MaviKulubeliAdam/Automatic-MLA-Tuner/pcb/MLA-Tuner.kicad_sch

## KiCad design pcb/MLA-Tuner.kicad_sch (2025-12-02)

Schematic: MLA-Tuner.kicad_sch

Parts:
ATT1: 20dB_Attenuator; Attenuator_20dB
BR1: SWR_Bridge_T50-2; SWR_Bridge
C1, C3, C4, C5: 100nF; C_0805_2012Metric
C2: 100uF; CP_Radial_D8.0mm_P3.50mm
J1: 5V_DC_Jack; BarrelJack_Horizontal
J2: 12V_DC_Jack; BarrelJack_Horizontal
J3: SMA_ANT_OUT; SMA_Amphenol_132289_EdgeMount
J4: MOTOR_CONN; PinHeader_1x04_P2.54mm_Vertical
J5: ENCODER_CONN; PinHeader_1x05_P2.54mm_Vertical
K1: 5V_Relay_Module; Relay_Module_1CH
M1: NEMA17_Stepper; NEMA17
SW1: Rotary_Encoder; RotaryEncoder_Alps_EC11E-Switch_Vertical_H20mm
SW2: BTN_FORWARD; SW_PUSH_6mm
SW3: BTN_REVERSE; SW_PUSH_6mm
U1: Arduino_Mega2560
U2: AD9833_Module
U3: RF_AMP_1MHz-3GHz; RF_Amplifier_Module
U4: TB6600_Driver
U5: AD8307_FWD; AD8307_Module
U6: AD8307_REF; AD8307_Module

Notes on the sheet:
MANYETIK LOOP AUTO-TUNER PCB v4.0 ================================ Bu PCB tasarımı aşağıdaki modülleri içerir: 1. Arduino Mega 2560 - Ana kontrolör 2. AD9833 DDS - Sinyal üretici (0-12.5 MHz) 3. RF Amplifier - 1MHz-3GHz (+20dB) 4. 5V Röle Modülü - RF Amp güç kontrolü 5. TB6600 - Step motor sürücü 6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
