MaviKulubeliAdam/Automatic-MLA-Tuner/(commit log)

2025-12-02 Add PCB design files for Magnetic Loop Auto-Tuner
    [MLA-Tuner.kicad_pcb, MLA-Tuner.kicad_sch]
2025-12-02 Address code review feedback: fix power pin, documentation links, and clarifications
    [MLA-Tuner.kicad_pcb, MLA-Tuner.kicad_sch]
2025-12-02 Update auto-mla-tuner to support AD9851 DDS
    - Changed DDS from AD9833 to AD9851, updating related pin definitions and initialization.
    - Adjusted frequency range to 0-60 MHz for AD9851.
    - Modified functions to handle AD9851's specific communication protocol.
    - Added RF mode control for switching between TUNE and OPERATE modes.
    - Updated serial output messages to reflect changes in hardware and functionality.
